mrkrueger3/ECE455-Finding-Titan/SP26_FindingTitan_PulserSizingCalculations_RyanNowak.pdf

# 455 Random assembled notes

Nowak Nowak

February 2026

Capstone Notes May 6, 2026

## 1 Purpose

This document collects the key calculations used to (1) estimate the polarization coil electrical parameters and (2) size the switching transistors and protection network for a 12V battery-powered PPM pulser.

## 2 Known coil geometry (polarization coil)

From the coil design:

- Inner diameter: 11.4cm (4.488in) ⇒ rin = 5.7cm
- Coil length: 10.0cm (3.937in) ⇒ ℓ = 0.10m
- Turns: N = 228 (6 layers × 38 turns/layer)
- Wire: 14 AWG copper (bare diameter ≈ 1.628mm; insulated diameter depends on enamel/build)

For multilayer coils, the inductance depends on the mean radius and winding thickness: ravg ≈ rin +

t
2
t ≈ Nlayers · dwire,ins A reasonable first estimate is dwire,ins ∼ 1.7mm, giving t ≈ 6 × 1.7 ≈ 10.2mm and ravg ≈ 6.2cm.

## 3 Inductance estimate

A standard engineering estimate for a multilayer solenoid is the Wheeler for-mula:
L(µH) ≈

0.8 r

2N²
6r + 9ℓ + 10t

(1)

where r, ℓ, and t are in inches (mean radius, coil length, winding thickness). Using:
r ≈ 2.44in, | ℓ ≈ 3.94in, | t ≈ 0.40in, | N = 228
| 1

L ≈

0.8(2.44)²

(228)²
6(2.44) + 9(3.94) + 10(0.40) µH ≈ 4.6e3H ≈ 4.6mH

Design value: L ≈ 4.6mH (air − coreestimate).

Uncertainty

Real inductance can vary ±10% to ±25% due to winding packing, insulation thickness, nearby conductors/metal, and measurement frequency. For design, it is honest to state:

L ≈ 46mH expected; measuretoconf irm.

## 4 Wire length and DC resistance estimate

Approximate total wire length using mean circumference: mean circumference C ≈ 2πravg
Lwire ≈ N · C With ravg ≈ 0.062m:

C ≈ 2π(0.062) ≈ 0.389m, Lwire ≈ 228(0.389) ≈ 88.7m

Copper resistance for 14 AWG is approximately 0.00829m at 20C.

Rcoil ≈ 0.00829 × 88.7 ≈ 0.74

Design value: Rcoil ≈ 0.7 (estimate; measure)

Temperature rise

Copper increases with temperature:

R(T) = R20 [1 + α(T − 20◦C)] , | α ≈ 0.00393/
◦C | (2)

Example: at 60C, R ≈ R20(1 + 0.00393 · 40) ≈ 1.16R20.

## 5 Pulse current and polarization field

### 5.1 Peak current (battery-limited)

For a 12V battery and low-side MOSFET switch, the peak current is approximately:

Ipeak ≈

Vbat

Rcoil + Rswitch + Rwiring

(3)

Ignoring small parasitics for first-pass:

Ipeak ≈

12
0.74

≈ 16A

(This is why low RDS(on) and thick wiring matter.)

2

### 5.2 Field at center (finite solenoid correction)

For a finite-length solenoid, the on-axis field at the center is:

B(0) ≈ µ0

N
ℓ

I ·

ℓ
2

p
r

2 + (ℓ/2)²

= µ0

NI
2

p
r

2 + (ℓ/2)²

(4)

Using r ≈ 0.062m, ℓ = 0.10m, N = 228, I = 16A:

1
2

p
r

2 + (ℓ/2)²

≈

1
2

√
0.062² + 0.05²

≈ 6.28

B(0) ≈ µ0NI(6.28) ≈ (1.256 × 10⁻⁶
)(228)(16)(6.28) ≈ 2.9e − 2T ≈ 29mT

Interpretation: tens of mT is a strong polarization field for a DIY PPM head (actual value depends on geometry and end effects).

## 6 Inductor energy and turn-off stress (why clamps matter)

The energy stored in the polarization coil at the end of the pulse is:

EL =

1
2

LI²
(5)

With L = 4.6mH and I = 16A:

EL ≈ 0.5(0.0046)(16²
) ≈ 0.59J

This energy must go somewhere at turn-off: into a TVS, a snubber, MOSFET avalanche, or back into the supply (active clamp).

### 6.1 Current decay rate vs clamp voltage

For low-side switching with coil top at +12 V and switch node clamped to

Vclamp:

VL = Vtop − Vbottom = 12 − Vclamp

dI
dt ≈

VL
L

= −

(Vclamp − 12)
L
Example:
- Diode-only clamp to +12 V (effectively Vclamp ≈ 12.7): |VL| ≈ 0.7V ⇒ dI/dt ≈ −0.7/0.0046 ≈ −150A/s
⇒ 16A takes ∼ 0.10s to decay (slow).
- TVS clamp to 60V (Vclamp = 60):
|VL| ≈ 48V ⇒ dI/dt ≈ −48/0.0046 ≈ −1.0e4A/s
⇒ 16A decays in ∼ 1.5ms (fast).

PPM implication: faster decay generally means shorter receiver blanking time and faster recovery.

3

## 7 MOSFET sizing and key checks

### 7.1 Voltage rating

MOSFET VDS must exceed the worst-case switch node excursion:

VDS,maxVclamp,peak + Vringing + margin

Practical guidance:

- If using a TVS clamp in the 5080V region, 100 V MOSFETs can work but margin is tight.
- 150 V MOSFETs are safer for early prototypes and unknown ringing.

### 7.2 Conduction loss (during pulse)

For n MOSFETs in parallel:

Req ≈

RDS(on)
n
, | Pcond ≈ I

2Req

Example: if each MOSFET is 6m and n = 3, Req ≈ 2m:

Pcond ≈ 16²
(0.002) ≈ 0.51W (duringpulse)

Average power is reduced by duty cycle.

### 7.3 Gate drive requirement

Total gate charge adds in parallel:

Qtotal ≈ nQg, | Igate ≈

Qtotal

tsw

Example: Qg = 120nC each, n = 3 ⇒ Qtotal = 360nC. To switch in tsw = 500ns:

Igate ≈

360nC
500ns

≈ 0.72A

Implication: a dedicated gate driver (multiple amps peak) is recommended for clean switching.

### 7.4 Per-device gate resistors

When paralleling MOSFETs, use one resistor per gate (typ. 1022) to reduce ringing and improve sharing.

4

## 8 Clamp / snubber energy checks (TVS sizing intuition)

Worst-case, assume the TVS absorbs most of EL each turn-off:

Epulse ≈ EL ≈ 0.6J

If the cycle period is Tcycle:

Pavg ≈

Epulse

Tcycle

Example: one pulse every 5s ⇒ Pavg ≈ 0.6/5 = 0.12W (average is small), but the TVS must survive the pulse current/energy.

## 9 Battery draw and runtime (back-of-envelope)

If pulse current is Ipeak, pulse width tp, and cycle period T:

Iavg ≈ Ipeak

tp
T

Example: Ipeak = 16A, tp = 1s, T = 5s:

Iavg ≈ 16 ·

1
5

= 3.2A

A 12V, 9Ah battery ideally provides:

tideal ≈

9
3.2

≈ 2.8h

Real runtime will be lower due to voltage sag, temperature, and Peukert effects.

## 10 How to measure L without an LCR meter (recommended)

Put a known power resistor Rs in series with the coil and apply a step (low duty). Measure current rise via the resistor:

i(t) = I∞

1 − e

−t/τ
, τ =

L

Rs + Rcoil

Pick Rs so the current is safe. Fit τ from the waveform and compute:

L = τ (Rs + Rcoil)

## 11 Summary table (design starting numbers)

5

Quantity | Estimate | Notes
Inductance L | 4.6mH | Wheeler multilayer estimate
Resistance Rcoil | 0.7 | from wire length
Peak current @ 12V | 16A | neglecting switch/wiring drops
Stored energy EL | 0.6J | 0.5LI²
Center field (rough) | 30mT | finite-solenoid correction

6
