mrkrueger3/ECE455-Finding-Titan/SP26_FindingTitan_SensorHeadPhysics_RyanNowak.pdf

## Proton-Precession Magnetometer Physics calculations project details and Sensor-Head Design Notes

Physics & Math Behind the Coil Geometry and Sizing for a Target: 1 nT Resolution

## 1. What the sensor head must do

A proton-precession magnetometer measures the magnitude of the ambient magnetic field B0 by measuring the proton Larmor frequency:

f0 =

γp
2π
B0,

γp
2π
≈ 42.577 × 10⁶ Hz/T. | (1)

To Measure:

1. Polarize: Apply a strong temporary field Bp to align nuclear spins.
2. Switch off: Turn Bp off quickly and wait a short blanking delay.
3. Listen: Record the decaying precession signal (FID) and estimate f0, then compute B0.

## 2. What 1 nT means

A 1 nT field change corresponds to

∆f1 nT =

γp
2π
1 × 10⁻⁹ T ≈ 0.0426 Hz. | (2)

So achieving 1 nT resolution requires reliably estimating frequency to roughly 4 × 10⁻² Hz

## 3. Polarization physics

In thermal equilibrium at temperature T, nuclear polarization is small and scales linearly with Bp:

p ≈

µpBp
kT , | (3)

so the initial magnetization increases roughly linearly with Bp and with sample volume Vs:

M⊥(0) ∝ p Vs ∝ Bp Vs. | (4)

The magnetization builds during the polarization interval Tpol with a T1 time constant:

M(Tpol) = Meq
1 − e

−Tpol/T1

. | (5)

What this means for our groups Design: Increasing Bp and/or using a larger sample increases SNR; choosing a fluid with shorter T1 allows shorter cycles for the same magnetization.

## 4. Precession signal model

After switch-off, the transverse magnetization precesses about B0 and decays with T

∗
2

:

M⊥(t) = M⊥(0) e

−t/T ∗
2 cos(ω0t + ϕ), | ω0 = 2πf0. | (6)

A pickup coil converts changing flux into voltage:

v(t) = −Ns

dΦ(t)
dt | ⇒ (scaling) vsig ∝ Ns ω0 M⊥(0) (coupling). | (7)

Signal improves with Bp, sample volume, pickup turns Ns, and good geometric coupling.

## 5. Polarizing coil sizing

### 5.1 Field at center of a finite solenoid

For a solenoid of length ℓ, radius a, and N turns carrying current I, the on-axis field at the center can be approximated by:

Bp(0) ≈ µ0

N
ℓ

I · k, k =

ℓ
2

p
a

2 + (ℓ/2)²

=

1
p
1 + (2a/ℓ)

2

. | (8)

### 5.2 Ampere-turns requirement

Rearranging our previous equation gives the required ampere-turns for a target Bp:

NI ≈

Bp ℓ
µ0 k
. | (9)

Tradeoffs:

- Increasing N increases Bp for fixed I, but increases resistance R and inductance L.
- Increasing I increases Bp linearly, but increases heating P = I
2R.

### 5.3 Heating and duty cycle

Pcoil = I

2R, | Epulse = I
2R Tpol. | (10)

Design implication: We will need to Use thicker wire for a lower R if we plan to use high current without excessive heating.

## 6. Switch-off physics

The polarizer is an inductor; rapid switch-off uses voltage:

V ≈ L

∆I
∆t
. | (11)

and stores energy:

EL =

1
2

LI²
, | (12)

which must be safely dissipated or recovered every pulse. More turns can raise L substantially however it may force large switch-off voltages.

## 7. Pickup coil design (sensitivity vs noise)

### 7.1 Johnson noise

A dominant fundamental noise source is thermal (Johnson) noise of the pickup coil resistance:

en ≈

p
4kT R ∆f [Vrms], | (13)

where ∆f is measurement bandwidth.
This essentially means Increasing turns Ns raises signal but also increases resistance R raising. Most Practical DIY designs choose a wire gauge that balances these.

### 7.2 Gradiometer/coil cancellation

A single pickup coil is an antenna for environmental magnetic noise. A practical high-sensitivity approach uses two identical coils:

- Sample coil: contains the bottle, sees proton signal + environmental noise.
- Dummy coil: identical geometry/winding, no bottle, sees environmental noise only.

Wiring them in series opposition cancels common mode environmental pickup while preserving the proton signal. Matching turns, lead routing, potting, and cable is critical.

## 8. Orientation

The usable transverse magnetization after switch-off depends on the angle α between the polarization direction and the ambient field direction:

M⊥(0) ∝ M(Tpol) sin α. | (14)

By using a tilt mount we will be able to essentially choose α to avoid alignment that would reduce signal amplitude.

## 9. Our chosen baseline geometry (buildable + nT-capable)

The following geometry is a practical starting point that supports nT-class performance when paired with good switching/blanking and a stable timebase.

### 9.1 Polarizing coil

Target: Bp ≈ 7.5 mT (the needed baseline), with optional headroom for higher Bp if switching allows.

Parameter | Value
Coil inner diameter (ID) | 11.4 cm
Coil length ℓ | 10.0 cm
Turns N | 228 (6 layers × 38 turns/layer)
Radial winding thickness | 1.43 cm
Wire | 14 AWG solid copper (insulated)
Electrical (ballpark) | L ≈ 4.3 mH, R ≈ 1.1 Ω
Former material | Acrylic tube + acrylic end plates

### 9.2 Pickup coils (sample + dummy)

Parameter | Value

Coil inner diameter (ID) 3.8 cm
Coil length | 10.0 cm
Turns Ns (each coil) | 552 (4 layers × 138 turns/layer)
Wire | 22 AWG magnet wire
Electrical (ballpark) | L ≈ 3.5 mH, R ≈ 5.9 Ω (incl. cable)
Configuration | Two identical coils; bottle in one coil only

## 10. How this supports a 1 nT goal

1. Frequency target: 1 nT ↔ 0.0426 Hz.
2. SNR: Achieved by sufficiently large Bp , good fill factor , and cancellation (dummy coil).
3. Usable time: Keep T

∗
2

large by magnetic cleanliness and stable mechanics; minimize blanking so you use early high-SNR FID.

4. Switch-off: Ensure the polarizer clamp/switch can handle V ∼ L∆I/∆t and energy EL.
5. Timebase/estimator: Use a stable clock and a frequency estimator better than naive 1-second counting (may be constrained by budget).
