mrkrueger3/ECE455-Finding-Titan/SP26_FindingTitan_Expense_Report_Mason_Lebens.xlsx

Item | Quantity | Cost | Notes
Digikey prototype through-hole parts | 1 | 234.43
Digikey prototype through-hole parts | 1 | 25.93
Digikey prototype through-hole parts | 1 | 57.52
Amazon Towfish parts | 1 | 156
Digikey SMD Parts | 1 | 104.24
Amazon Towfish parts | 1 | 53.57
Digikey SMD Parts 2nd Order | 1 | 56.78
Remaining Funds |  | 11.53
