mrkrueger3/ECE455-Finding-Titan/SolidWorks CAD/SP26_FindingTitan_sample_bottle_Ryan_Nowak.SLDPRT

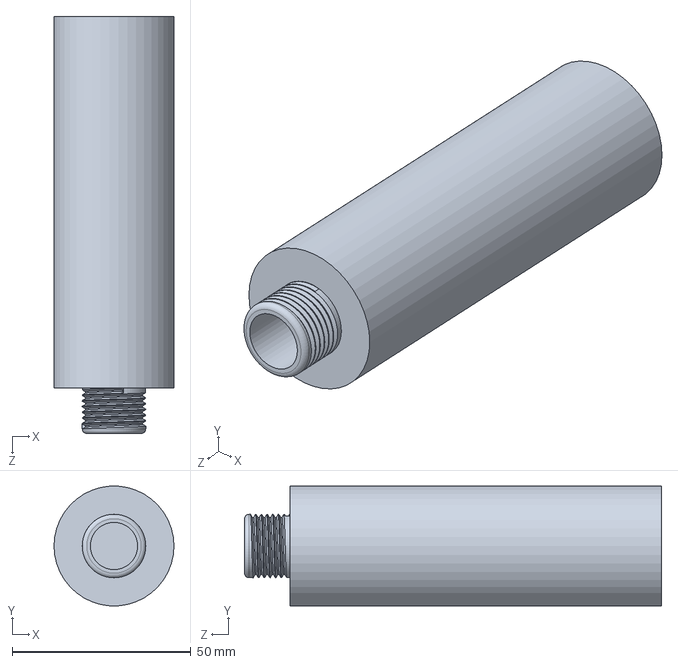
[picture p1: CAD file, 2026-05-06]
SolidWorks CAD/SP26_FindingTitan_sample_bottle_Ryan_Nowak.SLDPRT
33.5 x 33.4 x 116.5 mm
