mrkrueger3/ECE455-Finding-Titan/SolidWorks CAD/SP26_FindingTitan_coil_cap_plate_Ryan_Nowak.SLDPRT

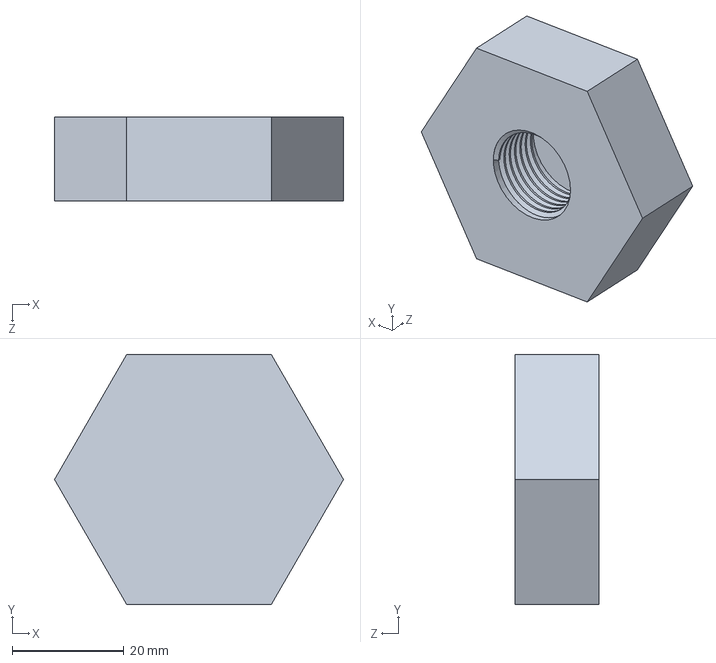
[picture p2: CAD file, 2026-05-06]
SolidWorks CAD/SP26_FindingTitan_coil_cap_plate_Ryan_Nowak.SLDPRT
51.6 x 44.7 x 15.0 mm
