mrkrueger3/ECE455-Finding-Titan/SolidWorks CAD/SP26_FindingTitan_coil_spool_Ryan_Nowak.SLDPRT

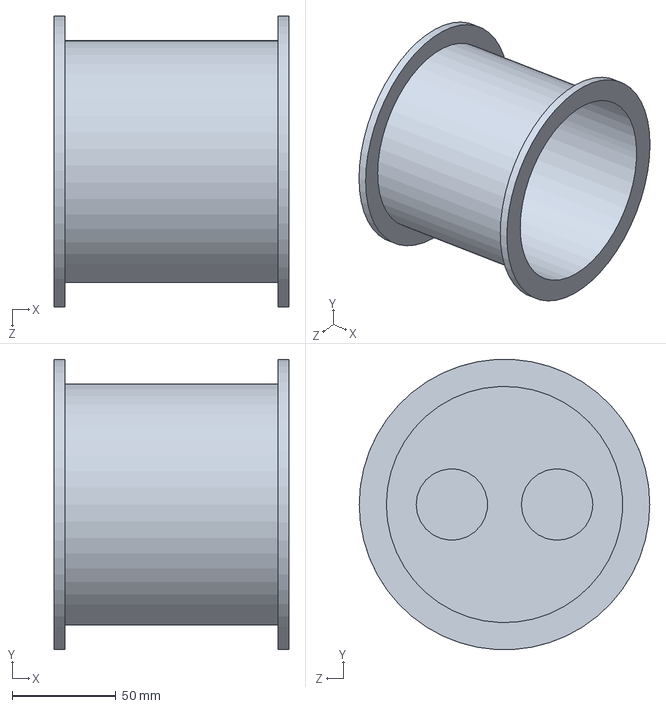
[picture p3: CAD file, 2026-05-06]
SolidWorks CAD/SP26_FindingTitan_coil_spool_Ryan_Nowak.SLDPRT
113.2 x 139.9 x 140.2 mm
