mrkrueger3/ECE455-Finding-Titan/SolidWorks CAD/SP26_FindingTitan_endcap_coil_holder_cap_Mason_Lebens.SLDPRT

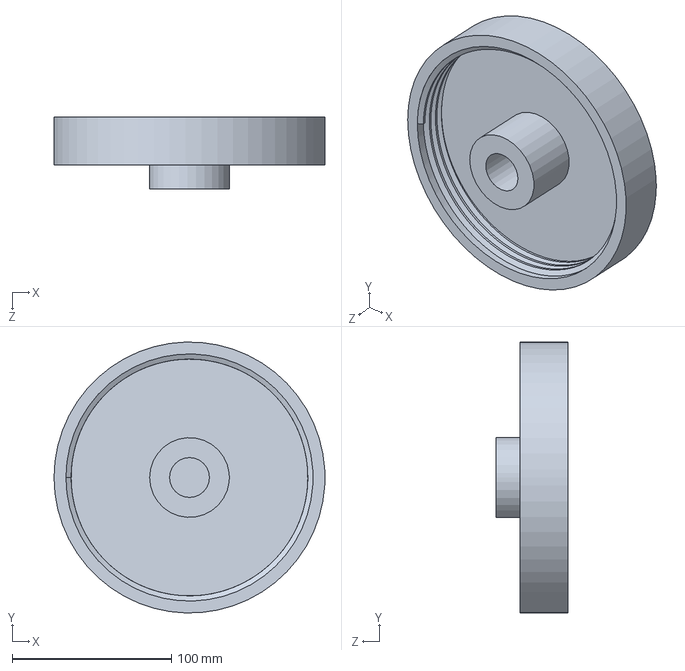
[picture p4: CAD file, 2026-05-03]
SolidWorks CAD/SP26_FindingTitan_endcap_coil_holder_cap_Mason_Lebens.SLDPRT
170.0 x 169.9 x 45.0 mm
