mrkrueger3/ECE455-Finding-Titan/SolidWorks CAD/SP26_FindingTitan_battery_holder_TEST_Mason_Lebens.SLDPRT

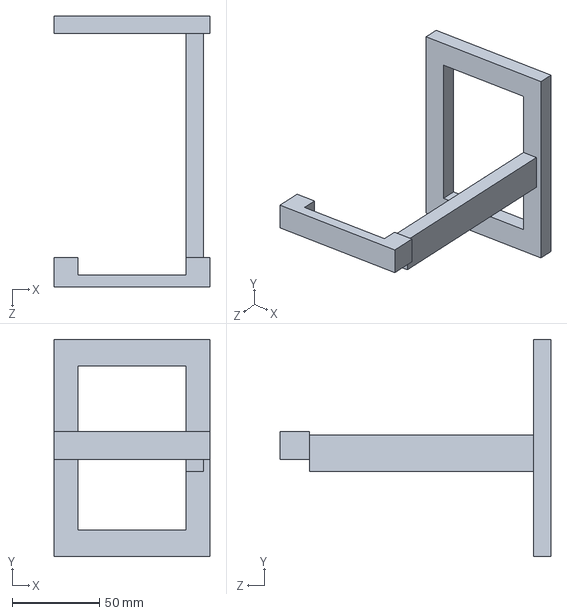
[picture p5: CAD file, 2026-05-03]
SolidWorks CAD/SP26_FindingTitan_battery_holder_TEST_Mason_Lebens.SLDPRT
89.0 x 124.4 x 155.0 mm
