mrkrueger3/ECE455-Finding-Titan/SolidWorks CAD/SP26_FindingTitan_polarize_coil_chuck_Mason_Lebens.STL

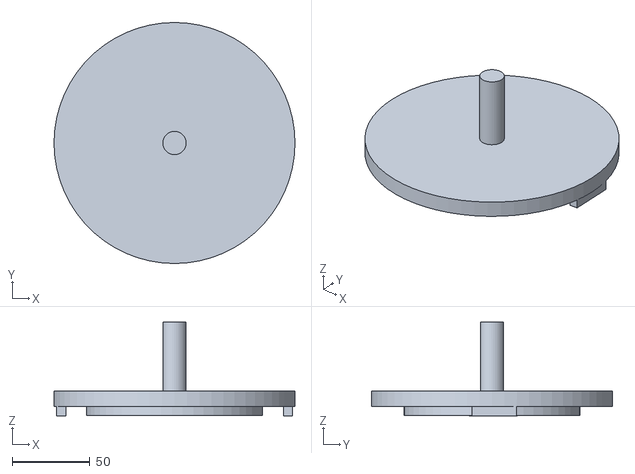
[picture p6: CAD file, 2026-05-03]
SolidWorks CAD/SP26_FindingTitan_polarize_coil_chuck_Mason_Lebens.STL
155.0 x 155.0 x 60.2
