mrkrueger3/ECE455-Finding-Titan/SolidWorks CAD/SP26_FindingTitan_battery_holder_pcb_mount_Mason_Lebens.SLDPRT

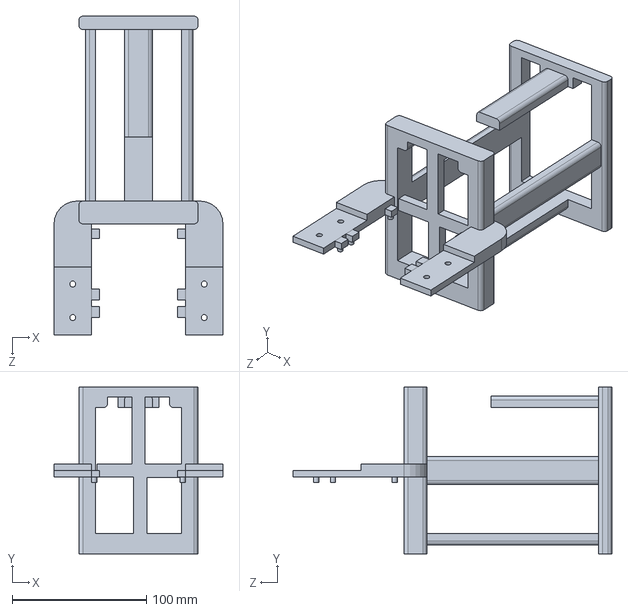
[picture p7: CAD file, 2026-05-03]
SolidWorks CAD/SP26_FindingTitan_battery_holder_pcb_mount_Mason_Lebens.SLDPRT
126.1 x 124.4 x 237.8 mm
