mrkrueger3/ECE455-Finding-Titan/SolidWorks CAD/SP26_FindingTitan_fin_collar_Mason_Lebens.SLDPRT

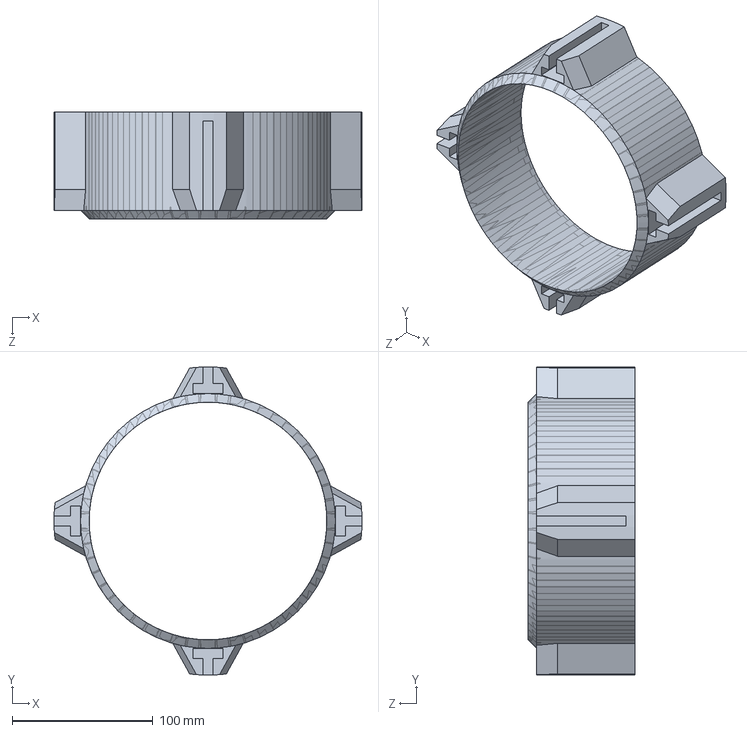
[picture p8: CAD file, 2026-05-03]
SolidWorks CAD/SP26_FindingTitan_fin_collar_Mason_Lebens.SLDPRT
218.9 x 218.9 x 75.9 mm
