mrkrueger3/ECE455-Finding-Titan/SolidWorks CAD/SP26_FindingTitan_dummy_sensor_chuck_Mason_Lebens.STL

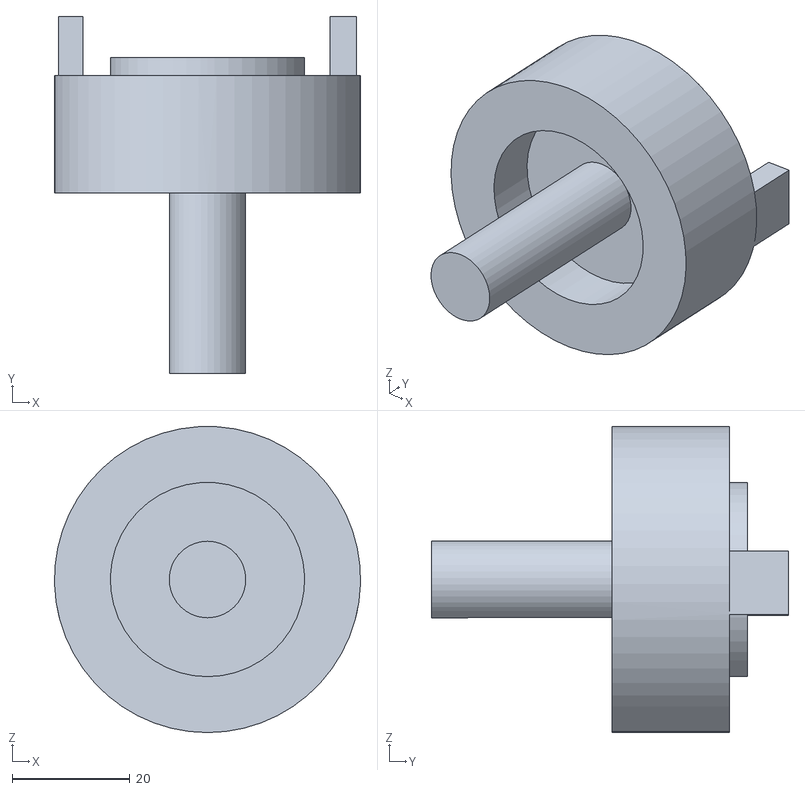
[picture p9: CAD file, 2026-05-03]
SolidWorks CAD/SP26_FindingTitan_dummy_sensor_chuck_Mason_Lebens.STL
52.0 x 60.6 x 52.0
