mrkrueger3/ECE455-Finding-Titan/SolidWorks CAD/SP26_FindingTitan_fin5_Mason_Lebens.SLDPRT

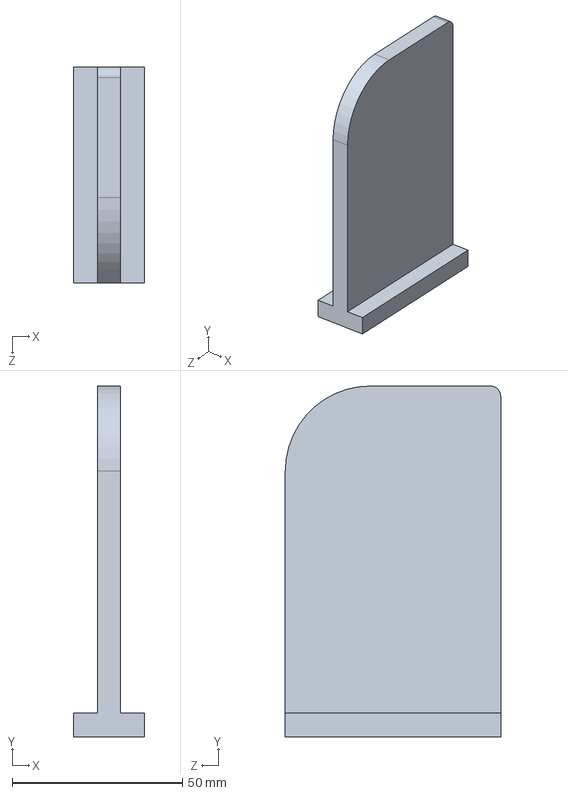
[picture p10: CAD file, 2026-05-03]
SolidWorks CAD/SP26_FindingTitan_fin5_Mason_Lebens.SLDPRT
20.8 x 103.1 x 63.3 mm
