mrkrueger3/ECE455-Finding-Titan/SolidWorks CAD/SP26_FindingTitan_perfboard_box_lid_Mason_Lebens.SLDPRT

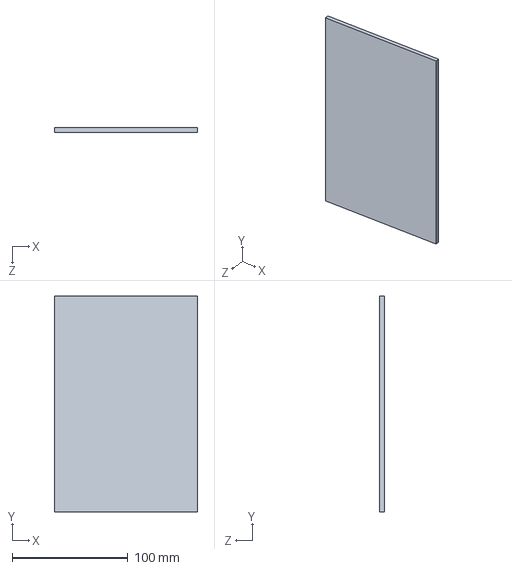
[picture p11: CAD file, 2026-05-03]
SolidWorks CAD/SP26_FindingTitan_perfboard_box_lid_Mason_Lebens.SLDPRT
123.8 x 186.4 x 4.00 mm
