mrkrueger3/ECE455-Finding-Titan/SolidWorks CAD/SP26_FindingTitan_polarization_coil_chuck_Mason_Lebens.SLDPRT

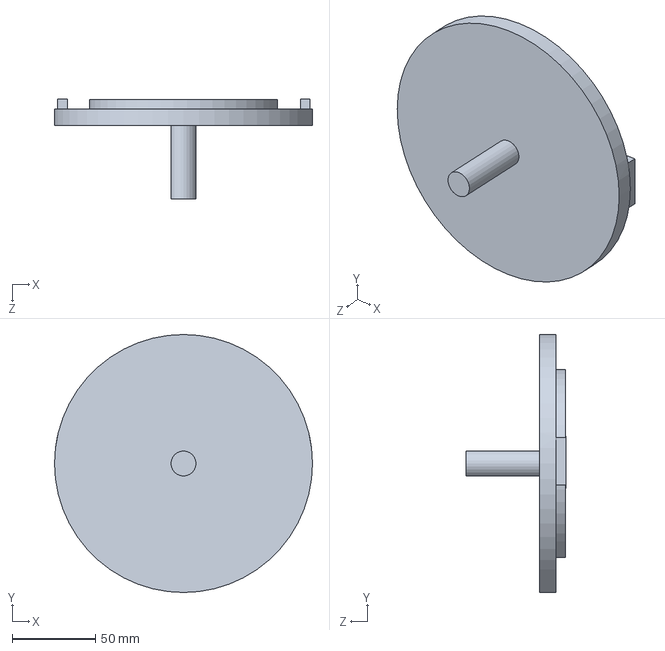
[picture p12: CAD file, 2026-05-03]
SolidWorks CAD/SP26_FindingTitan_polarization_coil_chuck_Mason_Lebens.SLDPRT
155.0 x 155.0 x 60.2 mm
