mrkrueger3/ECE455-Finding-Titan/SolidWorks CAD/SP26_FindingTitan_perfboard_box_Mason_Lebens.SLDPRT

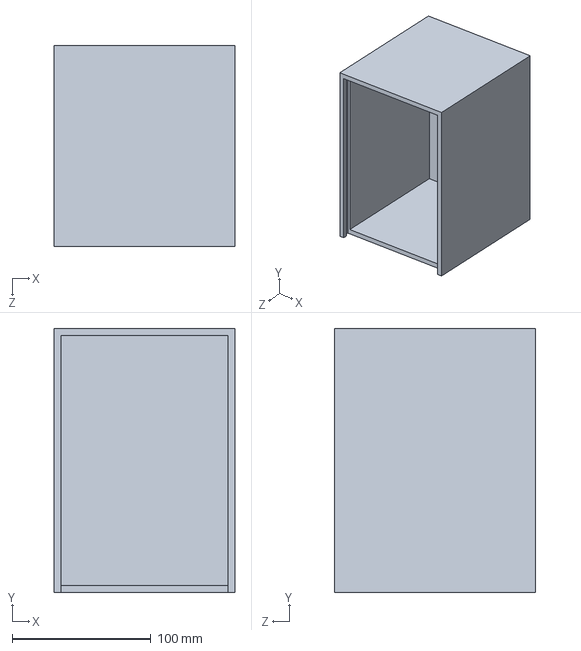
[picture p13: CAD file, 2026-05-03]
SolidWorks CAD/SP26_FindingTitan_perfboard_box_Mason_Lebens.SLDPRT
130.0 x 190.0 x 145.0 mm
