mrkrueger3/ECE455-Finding-Titan/SolidWorks CAD/SP26_FindingTitan_coil_holder_TEST_Mason_Lebens.SLDPRT

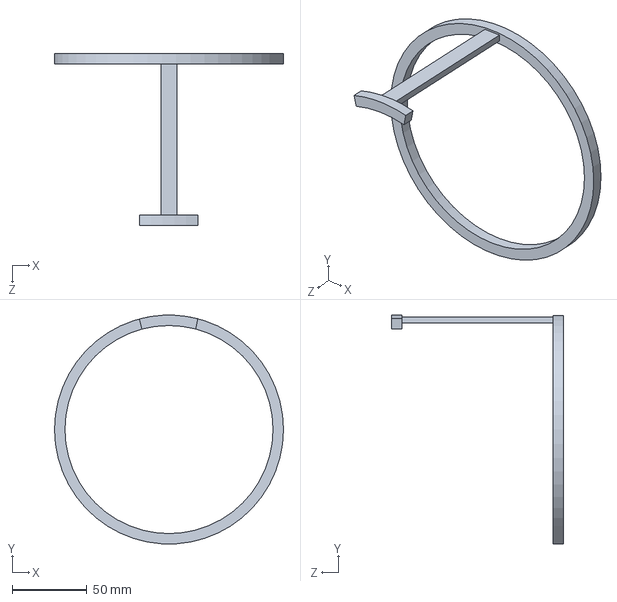
[picture p14: CAD file, 2026-05-03]
SolidWorks CAD/SP26_FindingTitan_coil_holder_TEST_Mason_Lebens.SLDPRT
153.0 x 152.8 x 115.0 mm
