mrkrueger3/ECE455-Finding-Titan/SolidWorks CAD/SP26_FindingTitan_Endcap_coil_holder_Mason_Lebens.SLDPRT

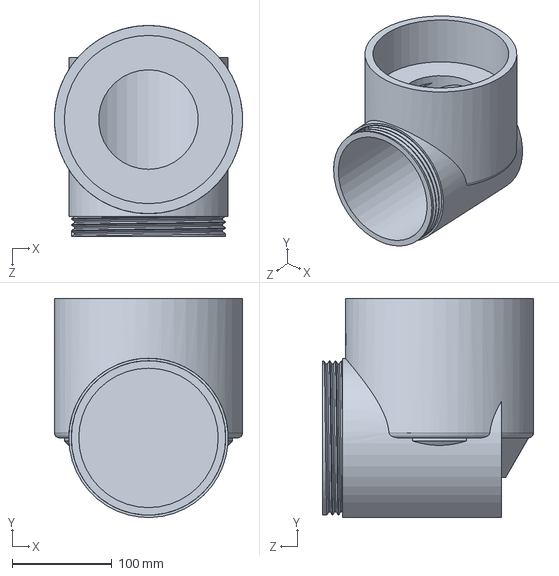
[picture p15: CAD file, 2026-05-03]
SolidWorks CAD/SP26_FindingTitan_Endcap_coil_holder_Mason_Lebens.SLDPRT
189.0 x 219.9 x 212.0 mm
