mrkrueger3/ECE455-Finding-Titan/SolidWorks CAD/SP26_FindingTitan_coil_holder_pcb_mount_Mason_Lebens.SLDPRT

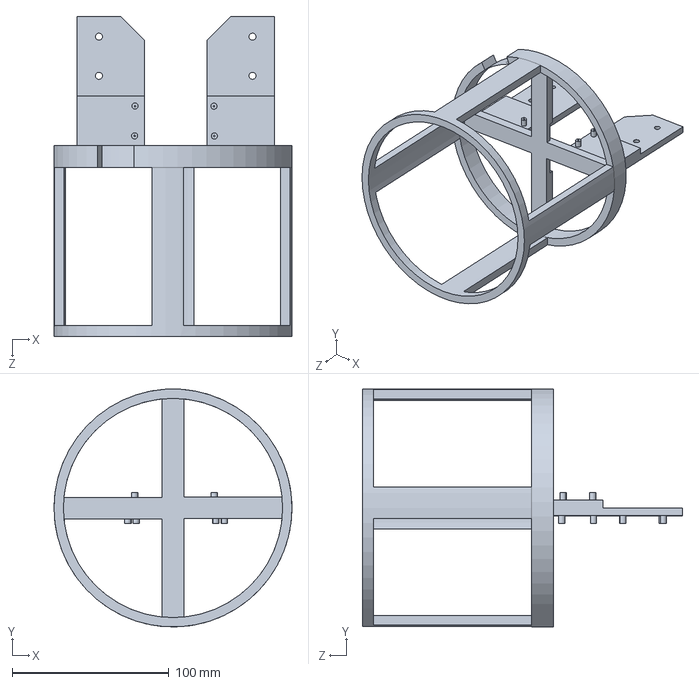
[picture p16: CAD file, 2026-05-03]
SolidWorks CAD/SP26_FindingTitan_coil_holder_pcb_mount_Mason_Lebens.SLDPRT
152.0 x 151.9 x 204.4 mm
