mrkrueger3/ECE455-Finding-Titan/SolidWorks CAD/SP26_FindingTitan_fin_collar_end_cap_Mason_Lebens.SLDPRT

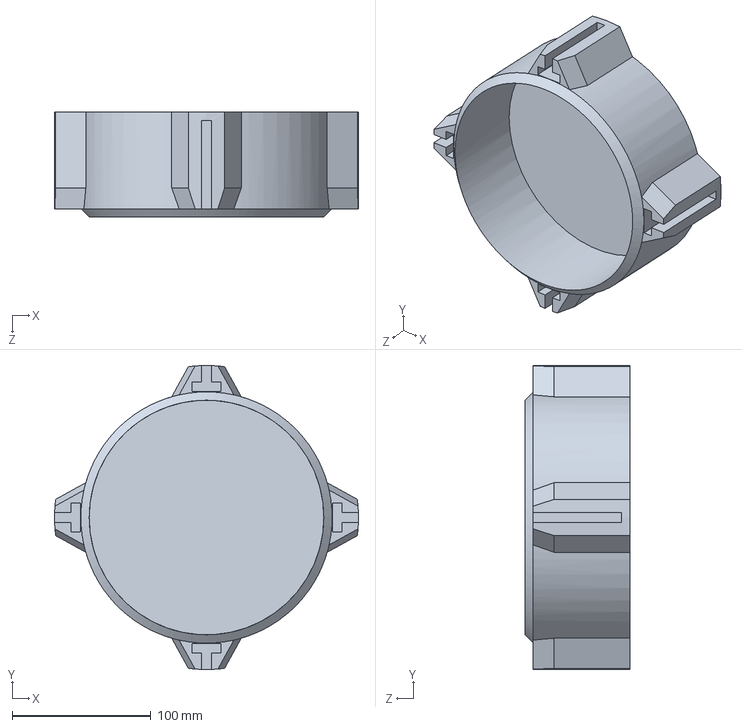
[picture p17: CAD file, 2026-05-03]
SolidWorks CAD/SP26_FindingTitan_fin_collar_end_cap_Mason_Lebens.SLDPRT
219.0 x 219.0 x 75.9 mm
