mrkrueger3/ECE455-Finding-Titan/SolidWorks CAD/SP26_FindingTitan_updated_assem_coil+batt_Mason_Lebens.SLDASM

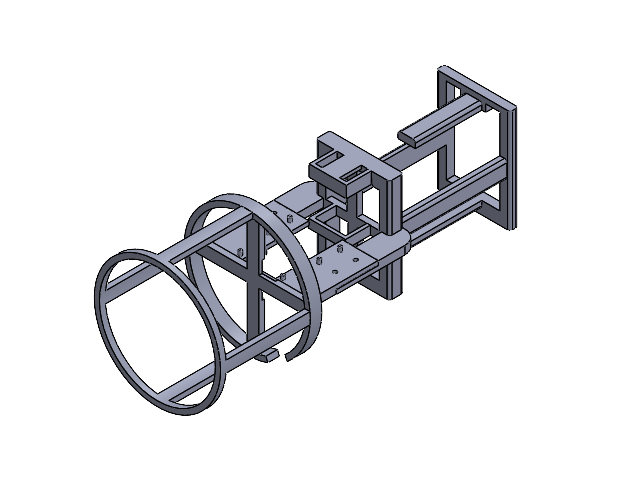
[picture p18: CAD file, 2026-05-03]
SolidWorks CAD/SP26_FindingTitan_updated_assem_coil+batt_Mason_Lebens.SLDASM
battery_holder_pcb_mount
coil_holder_pcb_mount
