mrkrueger3/ECE455-Finding-Titan/(list of files, cad)

Other CAD files:
Bambu Studio/SP26_FindingTitan_fin5_Mason_Lebens.gcode.3mf
Bambu Studio/SP26_FindingTitan_coil_holder_TEST_Mason_Lebens.gcode.3mf
Bambu Studio/SP26_FindingTitan_acryilic_fin_holder_Mason_Lebens.gcode.3mf
Bambu Studio/SP26_FindingTitan_battery_holder_TEST_Mason_Lebens.gcode.3mf
SolidWorks CAD/SP26_FindingTitan_dummy_chuck_Mason_Lebens.SLDPRT
SolidWorks CAD/SP26_FindingTitan_Endcap_coil_holder_Mason_Lebens.STL
SolidWorks CAD/SP26_FindingTitan_battery_holder_TEST_Mason_Lebens.STL
SolidWorks CAD/SP26_FindingTitan_battery_holder_pcb_mount_Mason_Lebens.STL
SolidWorks CAD/SP26_FindingTitan_coil_holder_TEST_Mason_Lebens.STL
SolidWorks CAD/SP26_FindingTitan_coil_holder_pcb_mount_Mason_Lebens.STL
SolidWorks CAD/SP26_FindingTitan_endcap_coil_holder_cap_Mason_Lebens.STL
SolidWorks CAD/SP26_FindingTitan_fin5_Mason_Lebens.STL
SolidWorks CAD/SP26_FindingTitan_fin_collar_Mason_Lebens.STL
SolidWorks CAD/SP26_FindingTitan_fin_collar_end_cap_Mason_Lebens.STL
SolidWorks CAD/SP26_FindingTitan_perfboard_box_Mason_Lebens.STL
SolidWorks CAD/SP26_FindingTitan_perfboard_box_lid_Mason_Lebens.STL
