mrkrueger3/ECE455-Finding-Titan/LtSpice/SP26_FindingTitan_Polarization_ckt_Mason_Lebens.asc

C1: cap; 4.7n
C2: cap; 0.1µ
C3: cap; 2.2µ
C4: cap; 4700µ
C5: cap; 0.1µ
D6: TVSdiode; SMCJ33A
L1: ind; 4.8m
M1: nmos; IPB025N10N3
M2: nmos; IPB025N10N3
R1: res; 4.7; pwr=2
R4: res; 4.7; pwr=2
R5: res; 4.7; pwr=2
R6: res; 4.7
R7: res; 2.2
V1: voltage; PULSE(0 12 1m 50n 50n 10m 3)
V2: voltage; 12
Named nets: 0, gate1, gate2, source, 12_prot
.include "C:\\ECE 455\\PESD15VL2BT.lib"
.tran 0 7 0 5m uic
.ic I(L1)=0
.options plotwinsize=0
.options method=gear
