mrkrueger3/ECE455-Finding-Titan/(list of files, drawings)

Other design files:
Altium/SP26_FindingTitan_Blanking&Pre_Amp_Michael_Krueger.SchDoc
Altium/SP26_FindingTitan_Digital Circuitry_Prakul Swaminath.SchDoc.SchDoc
Altium/SP26_FindingTitan_Filt&post_Amp_Michael_Krueger.SchDoc
Altium/SP26_FindingTitan_Polarization_Circuit_Mason_Lebens (2).SchDoc
Altium/SP26_FindingTitan_PWr & GND_Michael_Krueger.SchDoc
