mrkrueger3/ECE455-Finding-Titan/(commit log)

2026-05-03 Altium FIles
    [SP26_FindingTitan_Blanking&Pre_Amp_Michael_Krueger.SchDoc, SP26_FindingTitan_Filt&post_Amp_Michael_Krueger.SchDoc, SP26_FindingTitan_PWr & GND_Michael_Krueger.SchDoc]
2026-05-03 Add SolidWorks CAD folder with .gitkeep
    Agent-Logs-Url: https://github.com/mrkrueger3/ECE455-Finding-Titan/sessions/1b373397-fde4-4e53-8cfc-fa0d3138ffaa
2026-05-03 Rename files to SP26_FindingTitan_*_Mason_Lebens pattern
    Agent-Logs-Url: https://github.com/mrkrueger3/ECE455-Finding-Titan/sessions/18d832d8-4b11-4d3f-bf69-127a53db3190
    [SP26_FindingTitan_Endcap_coil_holder_Mason_Lebens.SLDPRT, SP26_FindingTitan_Endcap_coil_holder_Mason_Lebens.STL, SP26_FindingTitan_acryilic_fin_holder_Mason_Lebens.gcode.3mf, SP26_FindingTitan_battery_holder_TEST_Mason_Lebens.SLDPRT, SP26_FindingTitan_battery_holder_TEST_Mason_Lebens.STL, SP26_FindingTitan_battery_holder_TEST_Mason_Lebens.gcode.3mf, SP26_FindingTitan_battery_holder_pcb_mount_Maso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]
2026-05-06 Add initial PPM Teensy firmware implementation
2026-05-06 Create Arduino Code
2026-05-06 Add PPM measurement functionality to Teensy firmware
2026-05-06 Main Arduino File
